Flynsky/Styro_Lola/README.md

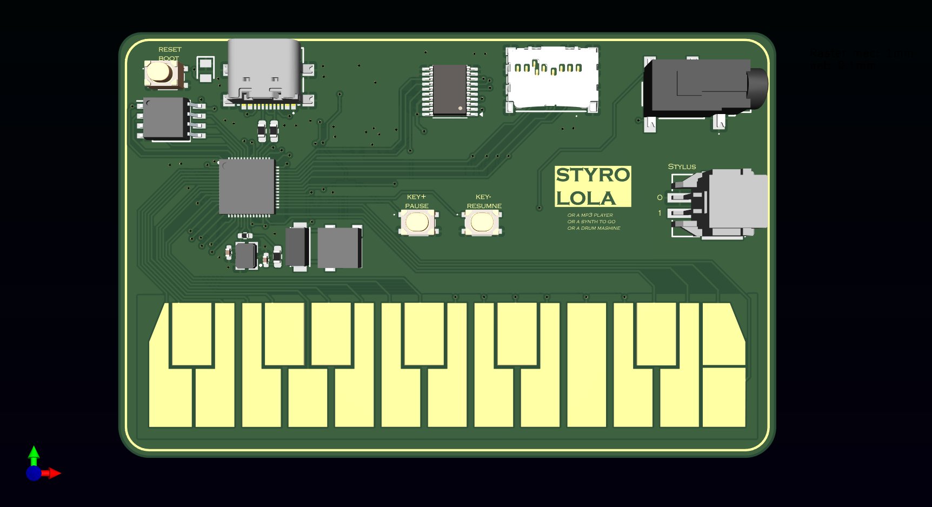
[picture p1: Hardware/V1/3D_Model/Credit_card_Midi_piano.png]
