Flynsky/Styro_Lola/Hardware/V1/Credit_card_Midi_piano.kicad_pcb

## KiCad design Hardware/V1/Credit_card_Midi_piano.kicad_pcb (2024-07-14)

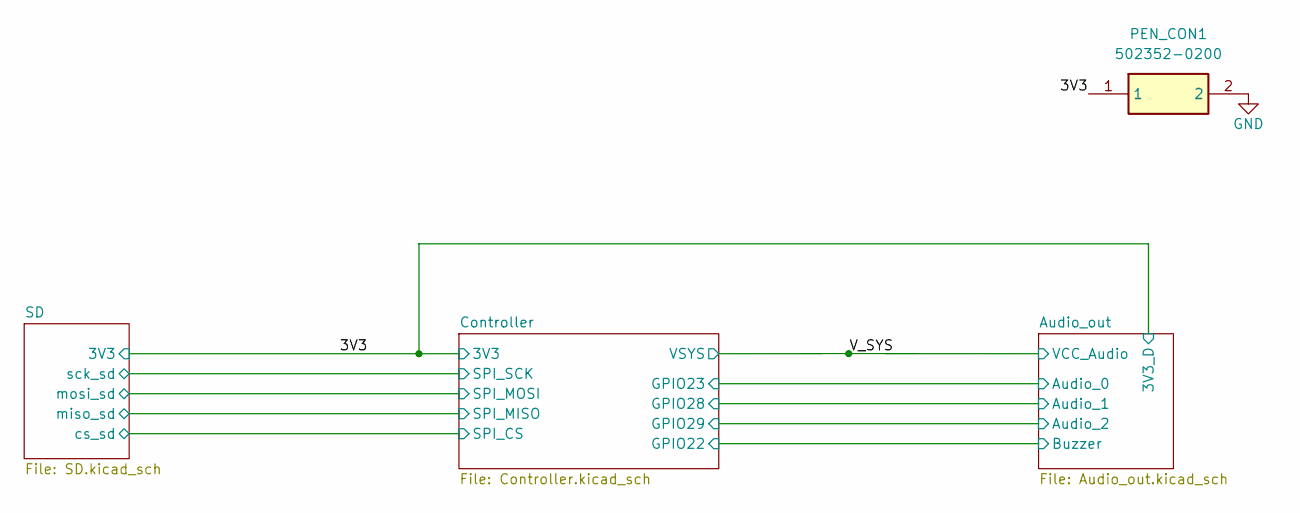
[picture p2: schematic Credit_card_Midi_piano.kicad_sch]

Parts:
PEN_CON1: 502352-0200; 5023520200; Mouser Part Number 538-502352-0200

Connections:
/3V3: PEN_CON1.1; also elsewhere on the board
GND: PEN_CON1.2; also elsewhere on the board

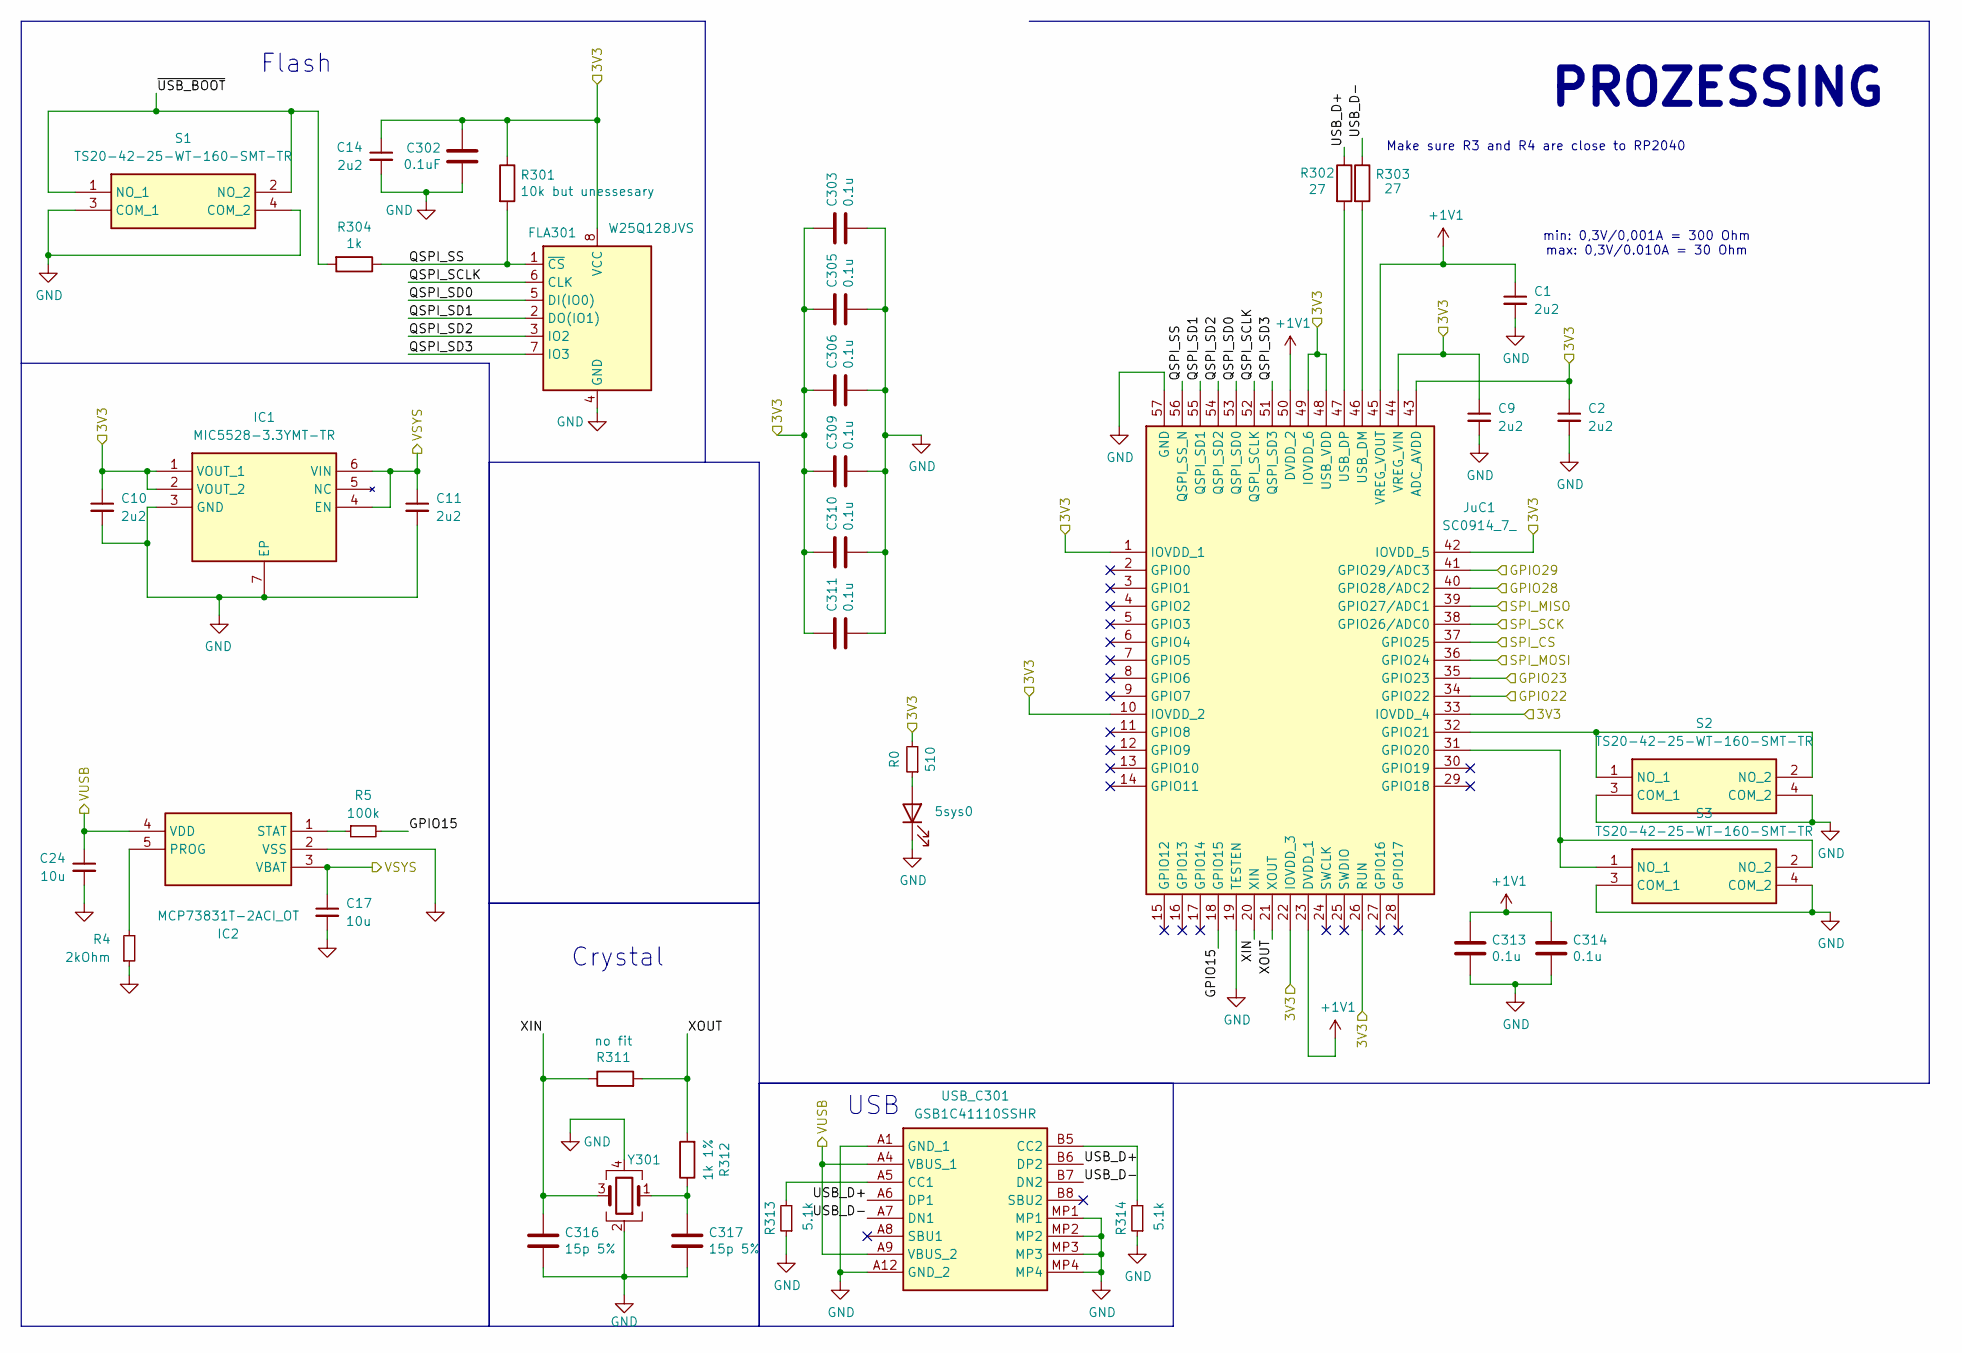
[picture p3: schematic Controller.kicad_sch]

Parts:
5sys0: APTD2012LCGCK; LEDC2012X120N; Mouser Part Number 604-APTD2012LCGCK
C1, C2, C9, C10, C11, C14: 2u2; CAPC1608X90N; Mouser Part Number 963-LMK107BJ225KA-T
C17, C24: 10u; CAPC1608X50N; Mouser Part Number 963-JMK107ABJ106MA-T
C302: 0.1uF; C_0402_1005Metric_Pad0.74x0.62mm_HandSolder
C303, C305, C306, C309, C310, C311, C313, C314: 0.1u; C_0402_1005Metric_Pad0.74x0.62mm_HandSolder
C316, C317: 15p 5%; C_0402_1005Metric_Pad0.74x0.62mm_HandSolder
FLA301: W25Q128JVS; SOIC127P790X216-8N
IC1: MIC5528-3.3YMT-TR; SON40P120X120X60-7N-D; Mouser Part Number 998-MIC5528-3.3YMTTR
IC2: MCP73831T-2ACI_OT; SOT95P270X145-5N; Mouser Part Number 579-MCP73831T-2ACIOT
JuC1: SC0914_7_; QFN40P700X700X90-57N-D; Mouser Part Number 358-SC09147
R0: 510; R_0603_1608Metric_Pad0.98x0.95mm_HandSolder
R4: 2kOhm; R_0603_1608Metric_Pad0.98x0.95mm_HandSolder
R5: 100k; R_0603_1608Metric_Pad0.98x0.95mm_HandSolder
R301: 10k but unessesary; R_0603_1608Metric_Pad0.98x0.95mm_HandSolder
R302, R303: 27; R_0603_1608Metric_Pad0.98x0.95mm_HandSolder
R304: 1k; R_0603_1608Metric_Pad0.98x0.95mm_HandSolder
R311: no fit; R_0402_1005Metric_Pad0.72x0.64mm_HandSolder
R312: 1k 1%; R_0603_1608Metric_Pad0.98x0.95mm_HandSolder
R313, R314: 5.1k; R_0603_1608Metric_Pad0.98x0.95mm_HandSolder
S1, S2, S3: TS20-42-25-WT-160-SMT-TR; TS204225WT160SMTTR; Mouser Part Number 179-TS204225WT160SMT
USB_C301: GSB1C41110SSHR; Manufacturer_Part_Number GSB1C41110SSHR
Y301: ABM8G-12.000MHZ-4Y-T3; ABM8G; Mouser Part Number 815-ABM8G-12-4YT3

Connections:
+1V1: C1.1, C313.1, C314.1, JuC1.23 (DVDD_1), JuC1.45 (VREG_VOUT), JuC1.50 (DVDD_2)
/3V3: C2.1, C9.1, C10.1, C14.1, C302.1, C303.1, C305.1, C306.1, C309.1, C310.1, C311.1, FLA301.8 (VCC), IC1.1 (VOUT_1), IC1.2 (VOUT_2), JuC1.1 (IOVDD_1), JuC1.10 (IOVDD_2), JuC1.22 (IOVDD_3), JuC1.26 (RUN), JuC1.33 (IOVDD_4), JuC1.42 (IOVDD_5), JuC1.43 (ADC_AVDD), JuC1.44 (VREG_VIN), JuC1.48 (USB_VDD), JuC1.49 (IOVDD_6), R0.2, R301.1; also elsewhere on the board
/Audio_out/Audio_0: JuC1.35 (GPIO23); also elsewhere on the board
/Audio_out/Audio_1: JuC1.40 (GPIO28/ADC2); also elsewhere on the board
/Audio_out/Audio_2: JuC1.41 (GPIO29/ADC3); also elsewhere on the board
/Audio_out/Buzzer: JuC1.34 (GPIO22); also elsewhere on the board
/Controller/GPIO15: JuC1.18 (GPIO15), R5.2
/Controller/QSPI_SCLK: FLA301.6 (CLK), JuC1.52 (QSPI_SCLK)
/Controller/QSPI_SD0: FLA301.5 (DI(IO0)), JuC1.53 (QSPI_SD0)
/Controller/QSPI_SD1: FLA301.2 (DO(IO1)), JuC1.55 (QSPI_SD1)
/Controller/QSPI_SD2: FLA301.3 (IO2), JuC1.54 (QSPI_SD2)
/Controller/QSPI_SD3: FLA301.7 (IO3), JuC1.51 (QSPI_SD3)
/Controller/QSPI_SS: FLA301.1 (~CS), JuC1.56 (QSPI_SS_N), R301.2, R304.1
/Controller/SPI_CS: JuC1.37 (GPIO25); also elsewhere on the board
/Controller/SPI_MISO: JuC1.39 (GPIO27/ADC1); also elsewhere on the board
/Controller/SPI_MOSI: JuC1.36 (GPIO24); also elsewhere on the board
/Controller/SPI_SCK: JuC1.38 (GPIO26/ADC0); also elsewhere on the board
/Controller/USB_D+: R302.1, USB_C301.A6 (DP1), USB_C301.B6 (DP2)
/Controller/USB_D-: R303.1, USB_C301.A7 (DN1), USB_C301.B7 (DN2)
/Controller/VUSB: C24.1, IC2.4 (VDD), USB_C301.A4 (VBUS_1), USB_C301.A9 (VBUS_2)
/Controller/XIN: C316.1, JuC1.20 (XIN), R311.1, Y301.3
/Controller/XOUT: JuC1.21 (XOUT), R311.2, R312.2
/Controller/~USB_BOOT: R304.2, S1.1 (NO_1), S1.2 (NO_2)
/V_SYS: C11.1, C17.1, IC1.4 (EN), IC1.6 (VIN), IC2.3 (VBAT); also elsewhere on the board
GND: 5sys0.1 (K), C1.2, C2.2, C9.2, C10.2, C11.2, C14.2, C17.2, C24.2, C302.2, C303.2, C305.2, C306.2, C309.2, C310.2, C311.2, C313.2, C314.2, C316.2, C317.2, FLA301.4 (GND), IC1.3 (GND), IC1.7 (EP), IC2.2 (VSS), JuC1.19 (TESTEN), JuC1.57 (GND), R4.1, R313.1, R314.1, S1.3 (COM_1), S1.4 (COM_2), S2.3 (COM_1), S2.4 (COM_2), S3.3 (COM_1), S3.4 (COM_2), USB_C301.A1 (GND_1), USB_C301.A12 (GND_2), USB_C301.MP1, USB_C301.MP2, USB_C301.MP3, USB_C301.MP4, Y301.2, Y301.4; also elsewhere on the board
unnamed: 5sys0.2 (A), R0.1
unnamed: C317.1, R312.1, Y301.1
unnamed: IC2.5 (PROG), R4.2
unnamed: IC2.1 (STAT), R5.1
unnamed: JuC1.31 (GPIO20), S3.1 (NO_1), S3.2 (NO_2)
unnamed: JuC1.32 (GPIO21), S2.1 (NO_1), S2.2 (NO_2)
unnamed: JuC1.46 (USB_DM), R303.2
unnamed: JuC1.47 (USB_DP), R302.2
unnamed: R313.2, USB_C301.A5 (CC1)
unnamed: R314.2, USB_C301.B5 (CC2)

Notes on the sheet:
min: 0,3V/0,001A = 300 Ohm max: 0,3V/0.010A = 30 Ohm
Crystal
Flash
USB
Make sure R3 and R4 are close to RP2040
PROZESSING

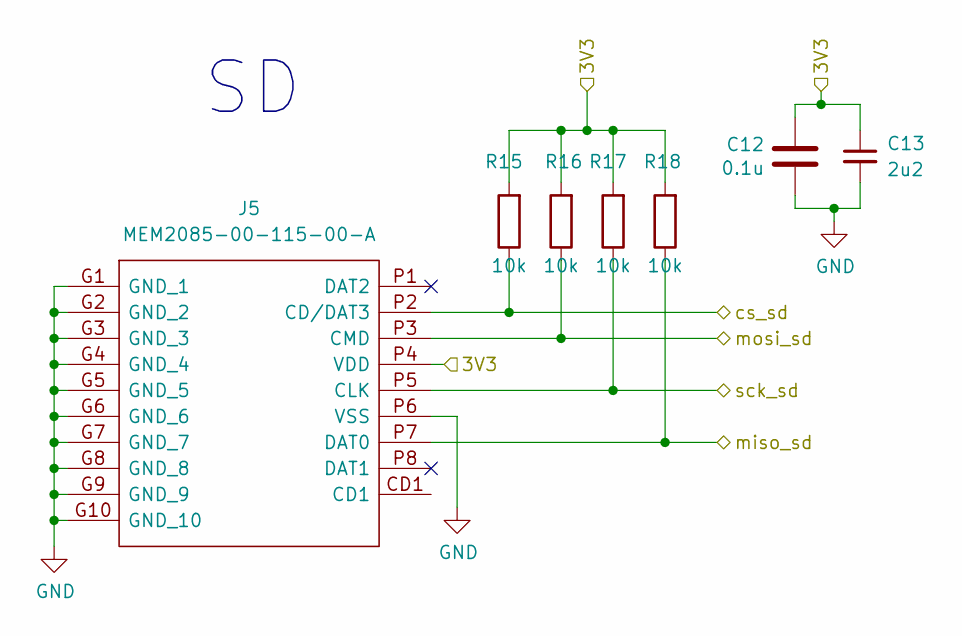
[picture p4: schematic SD.kicad_sch]

Parts:
C12: 0.1u; C_0402_1005Metric_Pad0.74x0.62mm_HandSolder
C13: 2u2; CAPC1608X90N; Mouser Part Number 963-LMK107BJ225KA-T
J5: MEM2085-00-115-00-A; MEM20850011500A; Mouser Part Number 640-MEM20850011500A
R15, R16, R17, R18: 10k; R_0603_1608Metric_Pad0.98x0.95mm_HandSolder

Connections:
/3V3: C12.1, C13.1, J5.P4 (VDD), R15.2, R16.2, R17.2, R18.2; also elsewhere on the board
/Controller/SPI_CS: J5.P2 (CD/DAT3), R15.1; also elsewhere on the board
/Controller/SPI_MISO: J5.P7 (DAT0), R18.1; also elsewhere on the board
/Controller/SPI_MOSI: J5.P3 (CMD), R16.1; also elsewhere on the board
/Controller/SPI_SCK: J5.P5 (CLK), R17.1; also elsewhere on the board
GND: C12.2, C13.2, J5.G1 (GND_1), J5.G2 (GND_2), J5.G3 (GND_3), J5.G4 (GND_4), J5.G5 (GND_5), J5.G6 (GND_6), J5.G7 (GND_7), J5.G8 (GND_8), J5.G9 (GND_9), J5.G10 (GND_10), J5.P6 (VSS); also elsewhere on the board

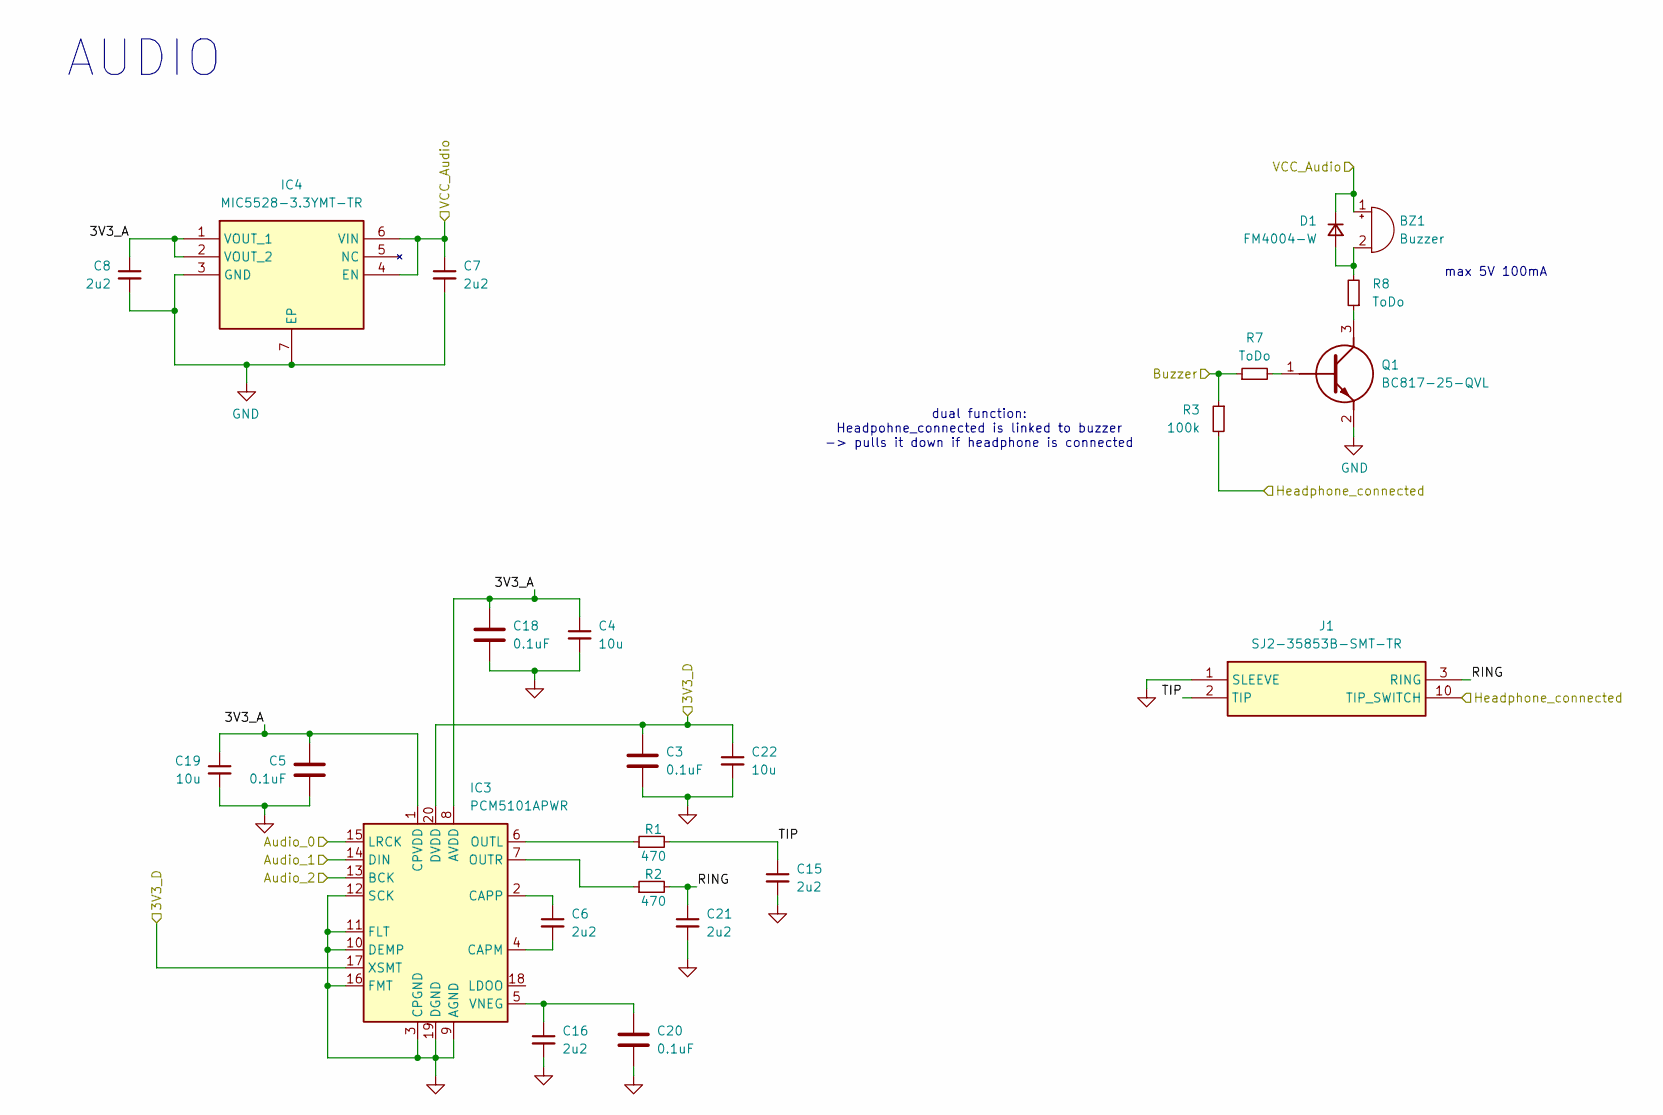
[picture p5: schematic Audio_out.kicad_sch]

Parts:
BZ1: Buzzer; CMT052575SMTTR
C3, C5, C18, C20: 0.1uF; C_0402_1005Metric_Pad0.74x0.62mm_HandSolder
C4, C19, C22: 10u; CAPC1608X50N; Mouser Part Number 963-JMK107ABJ106MA-T
C6, C7, C8, C15, C16, C21: 2u2; CAPC1608X90N; Mouser Part Number 963-LMK107BJ225KA-T
D1: FM4004-W; DIONM5025X231N; Mouser Part Number 583-FM4004
IC3: PCM5101APWR; TSSOP-20_4.4x6.5mm_P0.65mm; Mouser Part Number 595-PCM5101APWR
IC4: MIC5528-3.3YMT-TR; SON40P120X120X60-7N-D; Mouser Part Number 998-MIC5528-3.3YMTTR
J1: SJ2-35853B-SMT-TR; SJ235853BSMTTR; Mouser Part Number 490-SJ2-35853BSMT-TR
Q1: BC817-25-QVL; SOT95P230X110-3N; Mouser Part Number 771-BC817-25-QVL
R1, R2: 470; R_0603_1608Metric_Pad0.98x0.95mm_HandSolder
R3: 100k; R_0603_1608Metric
R7, R8: ToDo; R_0603_1608Metric

Connections:
/3V3: C3.2, C22.1, IC3.17 (XSMT), IC3.20 (DVDD); also elsewhere on the board
/Audio_out/3V3_A: C4.1, C5.2, C8.1, C18.2, C19.1, IC3.1 (CPVDD), IC3.8 (AVDD), IC4.1 (VOUT_1), IC4.2 (VOUT_2)
/Audio_out/Audio_0: IC3.15 (LRCK); also elsewhere on the board
/Audio_out/Audio_1: IC3.14 (DIN); also elsewhere on the board
/Audio_out/Audio_2: IC3.13 (BCK); also elsewhere on the board
/Audio_out/Buzzer: R3.1, R7.1; also elsewhere on the board
/Audio_out/Headphone_connected: J1.10 (TIP_SWITCH), R3.2
/Audio_out/RING: C21.1, J1.3 (RING), R2.2
/Audio_out/TIP: C15.1, J1.2 (TIP), R1.2
/V_SYS: BZ1.1 (+), C7.1, D1.1 (K), IC4.4 (EN), IC4.6 (VIN); also elsewhere on the board
GND: C3.1, C4.2, C5.1, C7.2, C8.2, C15.2, C16.2, C18.1, C19.2, C20.1, C21.2, C22.2, IC3.3 (CPGND), IC3.9 (AGND), IC3.10 (DEMP), IC3.11 (FLT), IC3.12 (SCK), IC3.16 (FMT), IC3.19 (DGND), IC4.3 (GND), IC4.7 (EP), J1.1 (SLEEVE), Q1.2 (E); also elsewhere on the board
unnamed: BZ1.2 (-), D1.2 (A), R8.2
unnamed: C6.2, IC3.4 (CAPM)
unnamed: C6.1, IC3.2 (CAPP)
unnamed: IC3.6 (OUTL), R1.1
unnamed: IC3.7 (OUTR), R2.1
unnamed: C16.1, C20.2, IC3.5 (VNEG)
unnamed: Q1.1 (B), R7.2
unnamed: Q1.3 (C), R8.1

Notes on the sheet:
AUDIO
dual function: Headpohne_connected is linked to buzzer -> pulls it down if headphone is connected
max 5V 100mA

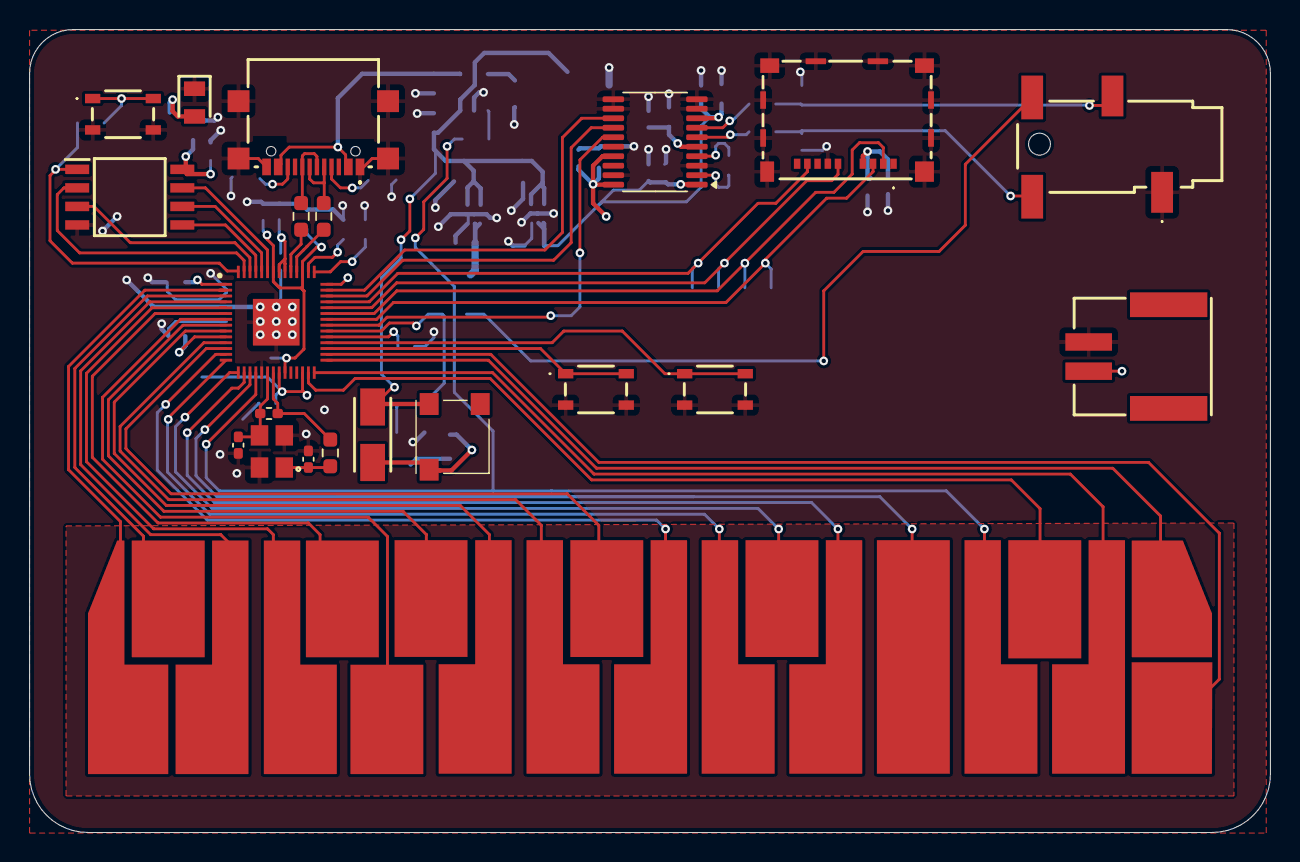
[picture p6: board Credit_card_Midi_piano.kicad_pcb from above]

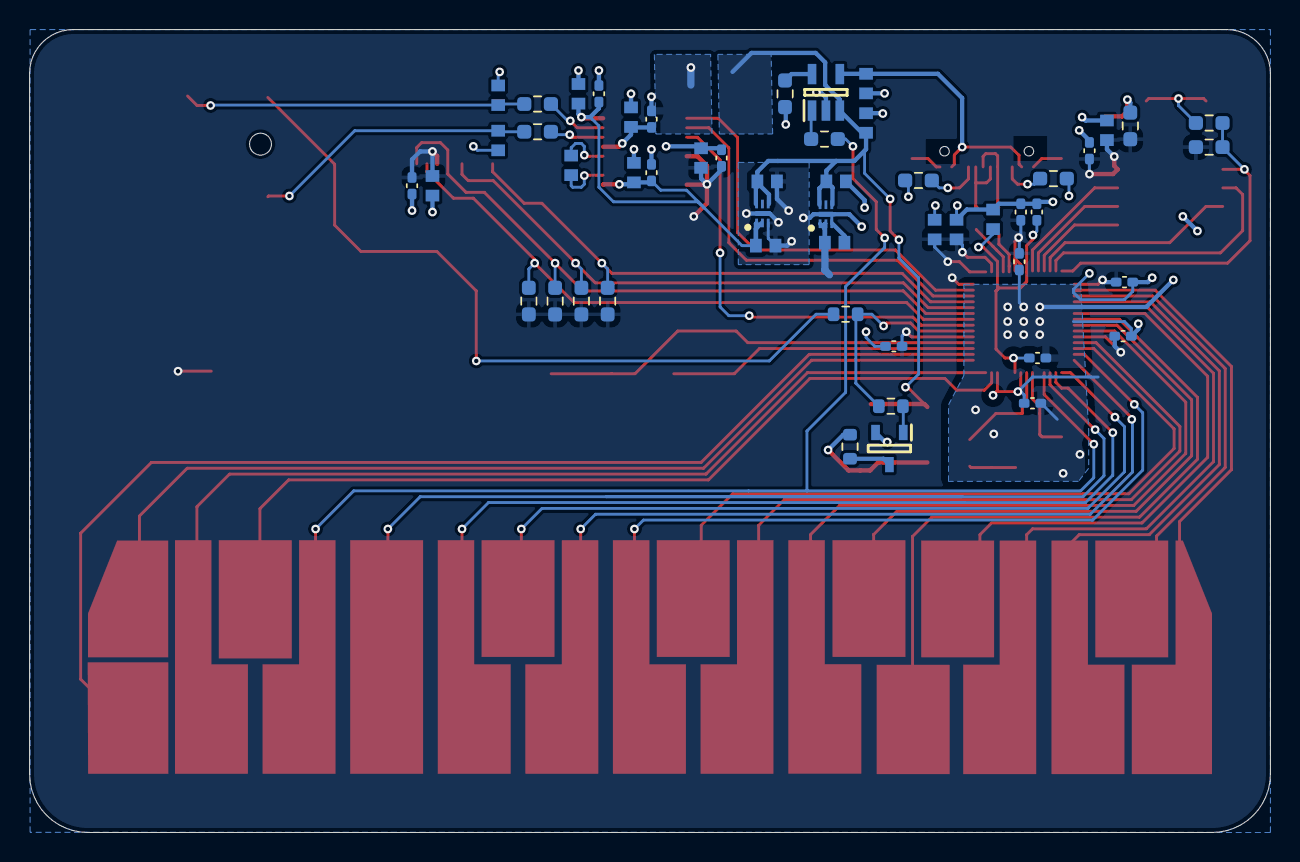
[picture p7: board Credit_card_Midi_piano.kicad_pcb from below]

Board: 2 copper layers, 85.0 x 55.0 mm, 72 parts (52 on the bottom side), 47 nets.
