Flynsky/Styro_Lola/(commit log)

2024-07-02 motherboard update
    [Audio_out.kicad_sch, Controller.kicad_sch, Credit_card_Midi_piano.kicad_pcb, Credit_card_Midi_piano.kicad_sch]
2024-07-03 added keys
    [Audio_out.kicad_sch, Controller.kicad_sch, Credit_card_Midi_piano.kicad_pcb, Credit_card_Midi_piano.kicad_sch]
2024-07-03 refined footprint
    [Audio_out.kicad_sch, Controller.kicad_sch, Credit_card_Midi_piano.kicad_pcb, Credit_card_Midi_piano.kicad_sch]
2024-07-18 changed to make boom better
    [Audio_out.kicad_sch, Boomer.xlsx, Controller.kicad_sch, Credit_card_Midi_piano.csv]
2025-05-29 wirked on iS2
    [Audio_out.kicad_sch, Controller.kicad_sch, Credit_card_Midi_piano.kicad_sch, SD.kicad_sch]
